pann/traincontrol/docs/AI for HW development.odp

## AI assisted Hardware development

March 2026 PA Nilsson

## Why use AI for electronics development?

## Exploratory phase

- Helps designer to better describe the project on a high level
  - Improved documentation for hand over or on-boarding of other engineers
- Based on high level requirements it can provide a good starting point on a block level

## Why use AI for electronics development?

## Implementation phase

- Component searches
  - Can provide component candidates based on soft high level requirements on components.
  - Verify component availability
- Power requirement calculations
  - Can produce good documentation on power budgets, reading datasheets and extracting data for all components in the design
- Find and download component symbols and create libraries where needed.
  - Can be instructed to analyze the design, then download and create missing components symbols and footprints.
- Draw a first block level schematics to set basic structure

## Why use AI for electronics development?

## Design review phase

- Act as an additional peer review participant
  - Review pinouts for component symbols and footprints
  - Find missing connections
- Power requirement calculations
  - Can produce good documentation on power budgets, reading datasheets and extracting data for all components in the design
- Find and download component symbols and create libraries where needed.
  - Can be instructed to analyze the design, then download and create missing components symbols and footprints.

## This work is licensed under a Creative Commons Attribution-ShareAlike 3.0 Unported License. It makes use of the works of Mateus Machado Luna.
