pann/traincontrol/docs/Rev1.0 review report.pdf

Traincontrol Shield -- Rev 1.0 Schematic Review | Date: 2026-03-02

# Traincontrol Shield

## Rev 1.0 Schematic Review Report

Review Date: 2026-03-02
Project: hw/traincontrol-shield/ Branch: hw-take2

## 1. Executive Summary

This report covers a schematic review of the traincontrol-shield KiCad project, a WiFi-enabled Marklin AC train controller shield for the ESP32-S3-DevKitC. The review focuses on the three project-local library components (MP2359DJ, DB107, BT134W-600D), their pinouts, reference circuit compliance, and LCSC/DigiKey availability. Standard KiCad library components were spot-checked for correct connections.
Result: 1 critical issue (missing Schottky diode), 3 warnings (component values), 1 sourcing concern (BT134W-600D out of stock on LCSC), and 1 informational note (DB107 pin numbering convention).

## 2. Scope of Review

Design input documents reviewed:
- docs/high-level-design.md - System architecture and hardware design
- hw/traincontrol-shield/PLAN.md - Implementation plan and design rules
- hw/traincontrol-shield/schematics-plan.md - Detailed schematic documentation
- hw/traincontrol-shield/BOM.md - Bill of materials
Schematic files reviewed (8 hierarchical sheets):
- traincontrol-shield.kicad_sch (top-level: connectors J4/J5/J6, sub-sheet instances)
- power-supply.kicad_sch (Sheet 1: DB107, MP2359DJ, bulk/output caps, feedback)
- zero-crossing.kicad_sch (Sheet 2: H11AA1 AC optocoupler)
- xor-interlock.kicad_sch (Sheet 3: 74LVC1G86 XOR + 74LVC2G08 dual AND)
- opto-triac-drive.kicad_sch (Sheet 4: 2x MOC3021 opto-TRIAC drivers)
- triacs-snubbers.kicad_sch (Sheet 5: 2x BT134W-600D + RC snubbers)
- rail-voltage-sense.kicad_sch (Sheet 6: resistor divider for ADC)
- mcu.kicad_sch (Sheet 7: ESP32-S3-DevKitC headers, LED, decoupling) Items checked:
- Pinouts of all project-local library components vs datasheets
- MP2359DJ reference circuit compliance
- Net naming consistency across sheets
- Hierarchical label connectivity
- LCSC part availability and JLCPCB assembly status
- DigiKey availability for all key components

## 3. Project-Local Component Review

The project-local library (libs/traincontrol-shield.kicad_sym) contains three components downloaded via easyeda2kicad. These are the only non-standard components and received detailed pinout verification against manufacturer datasheets.

### 3.1 MP2359DJ-LF-Z (U1) - Buck Converter

Ref | LCSC | Package | Footprint | Pinout | Status
U1 | C14259 | SOT-23-6 | Local lib | Verified OK | In stock

Pinout Verification (vs MPS datasheet):
Pin | Schematic | Datasheet | Match
1 | BST | BST | OK
2 | GND | GND | OK
3 | FB | FB | OK
4 | EN | EN | OK
5 | IN | IN | OK
6 | SW | SW | OK

Reference Circuit Compliance:

[CRITICAL] Missing Schottky freewheeling diode. The MP2359 is an asynchronous buck converter with no internal low-side MOSFET. An external Schottky diode (e.g. B230A, SS24, 2A/30V) must be connected from GND (anode) to SW node (cathode). Without this diode the converter will not function - inductor current has no path when the internal high-side switch turns off.
[WARNING] Bootstrap capacitor C9 = 100nF is 10x larger than datasheet recommendation of 10nF. While functional, it increases bootstrap charge time. Change C9 to 10nF.
[WARNING] Input decoupling capacitor C3 = 100nF is too small. Datasheet recommends 4.7uF ceramic (X5R/X7R) close to VIN pin. The 220uF electrolytic bulk cap (C1) has too much ESR/inductance at 1.4MHz switching frequency to serve as primary decoupling. Change C3 to 4.7uF ceramic. [WARNING] Feedback resistors R12=150k / R13=47k give VOUT = 0.81 x (1 + 150/47) = 3.39V (datasheet VFB = 0.810V typical, not 0.792V as noted in BOM). This is 2.7% high. Additionally, 150k top resistor is 3x larger than the recommended ~50k range and may affect loop stability. Datasheet recommends R1=49.9k, R2=16.2k for 3.3V output.
[OK] | EN tied to VIN for always-on operation: correct per datasheet.
[OK] | Inductor L1 = 4.7uH: within recommended 1-10uH range, matches typical application. Verify DC current
rating >= 1.5A.
[OK] Output capacitor C2 = 22uF: matches datasheet recommendation.

### 3.2 DB107 (D1) - Bridge Rectifier

Ref | LCSC | Package | Footprint | Pinout | Status
D1 | C2492 | DIP-4 THT | Local lib | See below | In stock

Pinout Verification:
Pin | Schematic | Std Datasheet | Match
1 | + (DC out) | ~ (AC in) | Differs
2 | - (DC out) | + (DC out) | Differs
3 | ~ (AC in) | ~ (AC in) | OK
4 | ~ (AC in) | - (DC out) | Differs
[INFO] | The easyeda2kicad symbol uses a non-standard pin numbering convention that differs from typical DB107 datasheets. However, since both the symbol AND footprint were downloaded together from LCSC/EasyEDA (C2492), the pad-to-pin mapping should be internally consistent. The physical board connections will be correct as long as the local footprint (DIO-BG-TH_DF) is used. Do NOT substitute a standard KiCad library footprint for this component without re-verifying pin mapping.
[OK] | Schematic connections are functionally correct: AC_IN and AC_RTN connect to the AC pins, +15VDC connects to the DC+ pin, GND connects to the DC- pin. The net assignments follow the design intent regardless of pin numbering convention.

### 3.3 BT134W-600D (Q1, Q2) - TRIACs

Ref | LCSC | Package | Footprint | Pinout | Status
Q1, Q2 | C253549 | SOT-223 | Local lib | Verified OK | OOS LCSC

Pinout Verification (vs NXP/WeEn datasheet):
Pin | Schematic | Datasheet | Match
1 | T1 (MT1) | T1 | OK
2 | T2 (MT2) | T2 | OK
3 | G (Gate) | G | OK
4 | T2 (tab) | T2 (heatsink) | OK
[OK] | Pinout matches NXP datasheet for SOT-223 package. All four pins verified correct.
[OK] | Circuit connections correct: MT1 to AC_RTN, MT2 to WINDING_A/B, Gate from opto-TRIAC via gate
resistor. RC snubbers (39 ohm / 10nF) across MT2-MT1.
[WARNING] LCSC C253549 is currently OUT OF STOCK (0 units). Part is available on DigiKey (~$0.55/ea, ships same day). For JLCPCB assembly, parts would need to be consigned or an alternative LCSC TRIAC sourced.

## 4. Part Availability Summary

### 4.1 LCSC / JLCPCB Assembly

LCSC | Component | Type | Stock | Price | Status
C14259 | MP2359DJ-LF-Z | Ext. | 490 | $2.63 | In stock
C2492 | DB107 | Ext. | 58,045 | $0.06 | In stock
C253549 | BT134W-600D | Ext. | 0 | $0.25 | OUT OF STOCK

All three project-local parts are JLCPCB 'Extended' components (not 'Basic'), incurring a one-time ~$3 setup fee per unique extended part per assembly order. Standard KiCad library components (passives, logic ICs, optocouplers) are not listed here as they use generic symbols and specific LCSC part numbers have not yet been assigned.

### 4.2 DigiKey Availability

Component | Package | Stock | Notes
MP2359DJ-LF-Z | SOT-23-6 | In stock | Ships same day
DB107 | DIP-4 THT | In stock | Multiple mfrs
BT134W-600D,115 | SOT-223 | In stock | ~$0.55/ea
H11AA1 | DIP-6 | In stock | Vishay/ON Semi
MOC3021 | DIP-6 | In stock | Lite-On/onsemi
74LVC1G86 | SOT-23-5 | In stock | Diodes/Nexperia/TI
74LVC2G08 | SC-70-6 | In stock | Nexperia/Diodes

All components are available on DigiKey with same-day shipping.

## 5. Schematic Connectivity Review

The hierarchical schematic structure was reviewed for correct inter-sheet connectivity. All signals verified to propagate correctly through the hierarchy.

### 5.1 Net Naming

The following net naming convention differences were noted between the design documentation and the actual schematics:

Design Doc Name | Schematic Name | Sheet | Status
GPIO_FWD | CTRL_A | XOR/MCU | Renamed
GPIO_REV | CTRL_B | XOR/MCU | Renamed
GATE_FWD | PHASE_A | XOR/Opto | Renamed
GATE_REV | PHASE_B | XOR/Opto | Renamed
TRIAC_FWD_G | TRIAC_A_GATE | Opto/TRIAC | Renamed
TRIAC_REV_G | TRIAC_B_GATE | Opto/TRIAC | Renamed
+15VDC | +15V | Power/Rail | Shortened
RAIL_SENSE | VSENSE | Rail/MCU | Shortened
LED_STATUS | LED_CTRL | MCU | Renamed
[INFO] | Net names in the schematics differ from the design documents (high-level-design.md and schematics-plan.md). The schematic names are more generic (CTRL_A/B, PHASE_A/B) while the doc names are more descriptive (GPIO_FWD/REV, GATE_FWD/REV). The documentation should be updated to match the schematics, or vice versa, to avoid confusion during layout and debugging.
[INFO] | The power net +15VDC (docs) vs +15V (schematic) mismatch could cause confusion. The schematic uses the KiCad standard power:+15V symbol. Consider updating the documentation to use +15V consistently.

### 5.2 Hierarchical Label Connectivity

All hierarchical sheet pins on the top-level sheet were verified to have matching hierarchical labels in their respective sub-sheets. Signal flow direction (input/output/bidirectional) is consistent across the hierarchy.
[OK] | All 12 inter-sheet signals correctly connected via global labels.
[OK] | Power nets (+15V, +3V3, GND) propagated via power symbols (no explicit wires needed).
[OK] | AC domain nets (AC_IN, AC_RTN) correctly isolated from logic domain by optocouplers.

### 5.3 MCU Pin Mapping

The ESP32-S3-DevKitC-1 is connected via two 22-pin headers (J1, J2). Signal assignments verified against the DevKitC-1 pinout:

Function | GPIO | Net | Header | SW Match
Motor FWD | 4 | CTRL_A | J1 pin 18 | Yes
Motor REV | 5 | CTRL_B | J1 pin 17 | Yes
Zero-cross | 6 | ZC_OUT | J1 pin 16 | Yes
Status LED | 8 | LED_CTRL | J1 pin 15 | Yes
Rail ADC | 2 | VSENSE | J2 pin 18 | Yes
[OK] | GPIO assignments match the software configuration in main/motor_control.c and main/status_led.c. GPIO 4/5/6/8/2 are correctly mapped to their intended functions.

## 6. Documentation Consistency

Cross-check of design input documents against the implemented schematics and BOM.

### 6.1 BOM vs Schematics

[OK] | All 36 components listed in BOM.md are present in the schematics.
[OK] | Component values match between BOM.md and schematic symbol properties.
[OK] | R10 = 27k (changed from 33k) correctly reflected in both BOM.md and schematic.
[OK] | Feedback resistors R12=150k, R13=47k present in both BOM and schematic.
[WARNING] | BOM.md states VFB = 0.792V for the MP2359DJ feedback calculation. The datasheet specifies
VFB = 0.810V (typical). This affects the calculated output voltage: 0.792V gives 3.31V, but 0.810V gives 3.39V. The BOM note should be corrected.
[WARNING] Missing Schottky diode not listed in BOM.md. Once added to the schematic, the BOM must be updated with the new component (e.g. B230A-13-F or SS24).

### 6.2 High-Level Design vs Schematics

[INFO] high-level-design.md specifies BTA204-600E (4A TO-220AB TRIAC). The schematic uses BT134W-600D (1A SOT-223). This substitution is documented in BOM.md but not in the high-level design document. Update high-level-design.md to reflect the actual part.
[INFO] high-level-design.md specifies snubber values 100 ohm / 100nF. The schematic uses 39 ohm / 10nF. Update the high-level design to match.
[INFO] high-level-design.md specifies ESP32-C3-MINI-1 as MCU. The schematic uses ESP32-S3-DevKitC-1 headers. This is a significant platform difference that should be documented. [INFO] Net naming differences between documentation and schematics (see Section 5.1). Recommend updating documentation to match actual schematic net names.

## 7. Findings Summary

### 7.1 Critical (must fix before fabrication)

1. Add external Schottky freewheeling diode (GND to SW node) for MP2359DJ

### 7.2 Warnings (should fix)

2. Change C9 (bootstrap) from 100nF to 10nF per datasheet
3. Change C3 (VIN decoupling) from 100nF to 4.7uF ceramic per datasheet
4. Change R12/R13 feedback resistors to 49.9k/16.2k per datasheet (or verify
current values are acceptable given VFB tolerance band)
5. Correct VFB value in BOM.md from 0.792V to 0.810V
6. BT134W-600D (C253549) out of stock on LCSC - plan for consignment or alternative

### 7.3 Informational (non-blocking)

### 7. DB107 pin numbering differs from standard datasheets (easyeda2kicad convention)

- Not a functional issue: symbol+footprint are internally consistent

### 8. Net names in schematics differ from design documents (see Section 5.1) 9. high-level-design.md has stale component specs (BTA204, ESP32-C3, snubber values) 10. All three LCSC parts are 'Extended' (setup fee per JLCPCB assembly order)

## 8. Recommended Actions

Before proceeding to PCB layout:

- 1. Add Schottky diode to power-supply sub-sheet and update generator script
- 2. Update C9, C3, R12, R13 values in schematic and BOM.md
- 3. Add new Schottky diode to BOM.md with LCSC part number
- 4. Re-run kicad-cli netlist export to validate updated schematics
- 5. Update high-level-design.md to reflect actual components and net names
- 6. Resolve BT134W-600D sourcing (consign from DigiKey or find LCSC alternative)
- 7. Assign LCSC part numbers to standard library components for JLCPCB assembly
