pann/traincontrol/hw/traincontrol-shield/mcu.kicad_sch

## KiCad design hw/traincontrol-shield/mcu.kicad_sch (2026-04-18)

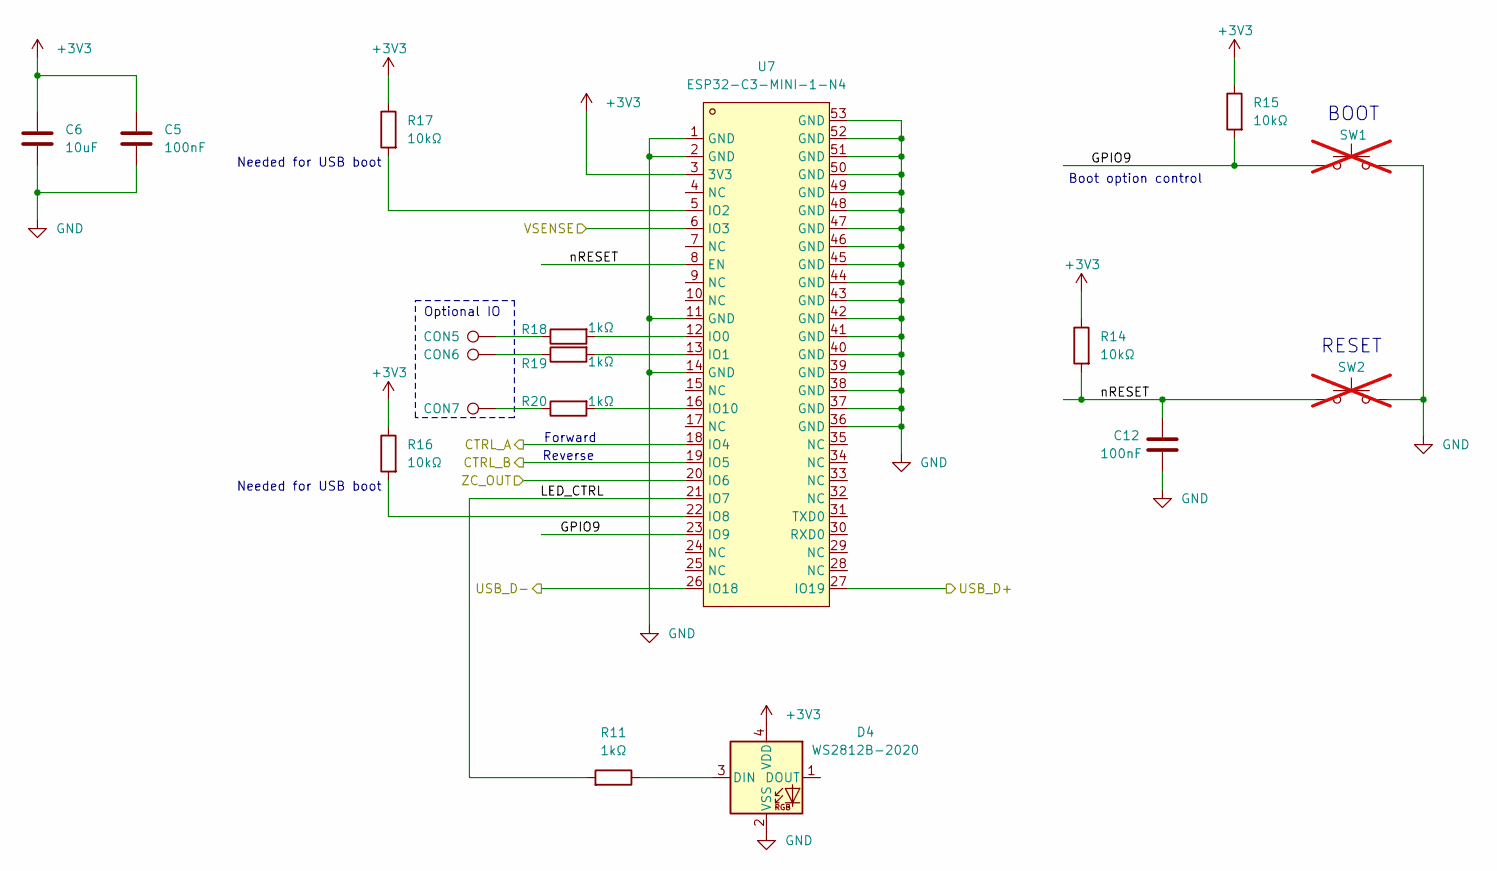
[picture p1: schematic mcu.kicad_sch]

Parts:
C5, C12: 100nF; C_0603_1608Metric
C6: 10uF; C_0603_1608Metric
CON5, CON6, CON7: ConnectionPad; TestPoint_Pad_D2.0mm
D4: WS2812B-2020; LED_WS2812B-2020_PLCC4_2.0x2.0mm
R11, R18, R19, R20: 1kΩ; R_0603_1608Metric
R14, R15, R16, R17: 10kΩ; R_0603_1608Metric
SW1, SW2: SW_Push; SW_SPST_TL3342; LCSC Part C318884; not fitted
U7: ESP32-C3-MINI-1-N4; WIFIM-SMD_ESP32-C3-MINI-1; LCSC Part C2838502

Connections:
+3V3: C5.2, C6.2, D4.4 (VDD), R14.1, R15.1, R16.1, R17.1, U7.3 (3V3)
CTRL_A: U7.18 (IO4)
CTRL_B: U7.19 (IO5)
GND: C5.1, C6.1, C12.2, D4.2 (VSS), SW1.2, SW2.2, U7.1 (GND), U7.2 (GND), U7.11 (GND), U7.14 (GND), U7.36 (GND), U7.37 (GND), U7.38 (GND), U7.39 (GND), U7.40 (GND), U7.41 (GND), U7.42 (GND), U7.43 (GND), U7.44 (GND), U7.45 (GND), U7.46 (GND), U7.47 (GND), U7.48 (GND), U7.49 (GND), U7.50 (GND), U7.51 (GND), U7.52 (GND), U7.53 (GND)
GPIO9: R15.2, SW1.1, U7.23 (IO9)
LED_CTRL: R11.2, U7.21 (IO7)
unnamed: CON5.1, R18.1
unnamed: CON6.1, R19.1
unnamed: CON7.1, R20.1
unnamed: D4.3 (DIN), R11.1
unnamed: R16.2, U7.22 (IO8)
unnamed: R17.2, U7.5 (IO2)
unnamed: R18.2, U7.12 (IO0)
unnamed: R19.2, U7.13 (IO1)
unnamed: R20.2, U7.16 (IO10)
USB_D+: U7.27 (IO19)
USB_D-: U7.26 (IO18)
VSENSE: U7.6 (IO3)
ZC_OUT: U7.20 (IO6)
nRESET: C12.1, R14.2, SW2.1, U7.8 (EN)

Notes on the sheet:
Optional IO
Reverse
Boot option control
Needed for USB boot
RESET
BOOT
Forward
