pann/traincontrol/hw/traincontrol-shield/opto-triac-drive.kicad_sch

## KiCad design hw/traincontrol-shield/opto-triac-drive.kicad_sch (2026-03-06)

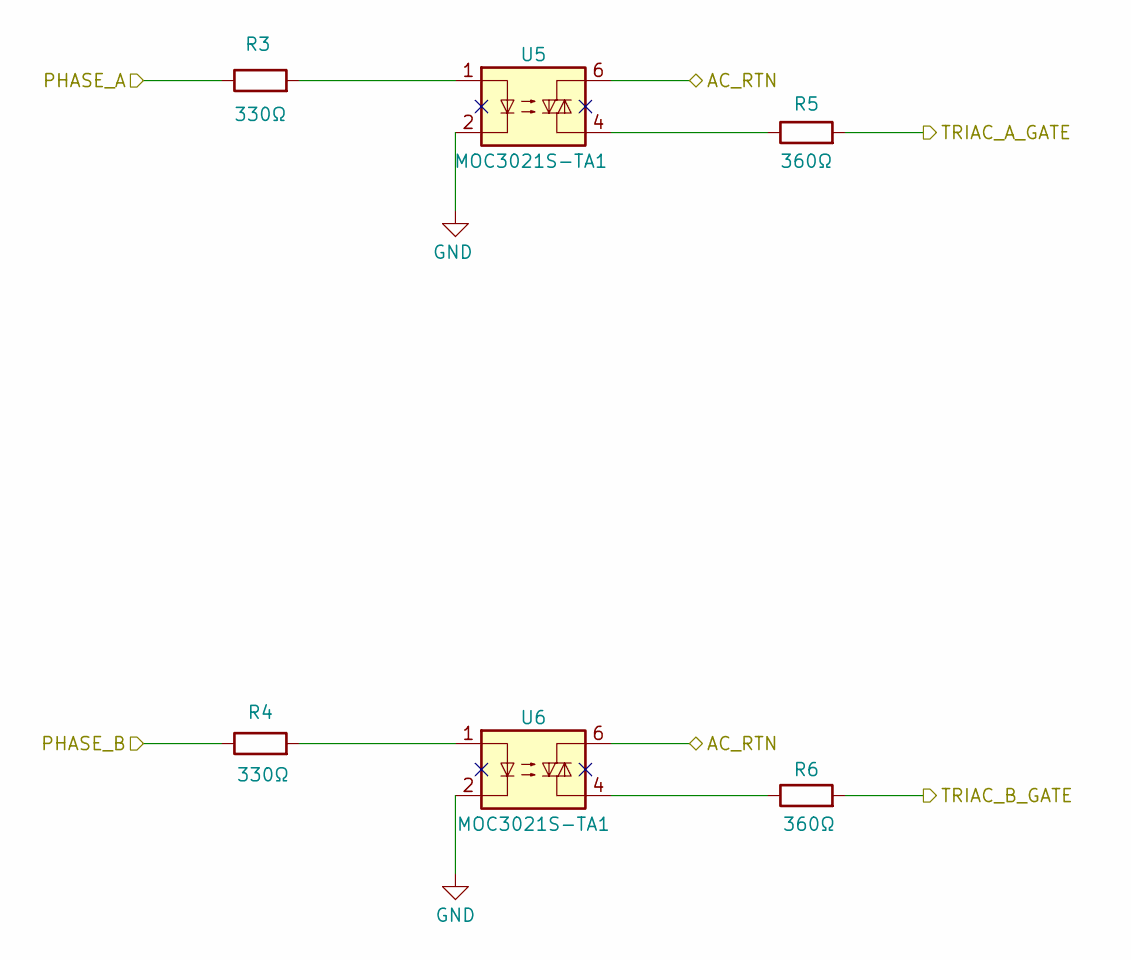
[picture p2: schematic opto-triac-drive.kicad_sch]

Parts:
R3, R4: 330Ω; R_0603_1608Metric
R5, R6: 360Ω; R_0603_1608Metric
U5, U6: MOC3021S-TA1; SMD-6_L7.3-W6.5-P2.54-LS10.2-BL; LCSC Part C115465

Connections:
AC_RTN: U5.6, U6.6
GND: U5.2, U6.2
unnamed: R3.2, U5.1
unnamed: R4.2, U6.1
unnamed: R5.1, U5.4
unnamed: R6.1, U6.4
PHASE_A: R3.1
PHASE_B: R4.1
TRIAC_A_GATE: R5.2
TRIAC_B_GATE: R6.2
