pann/traincontrol/hw/traincontrol-shield/power-supply.kicad_sch

## KiCad design hw/traincontrol-shield/power-supply.kicad_sch (2026-03-13)

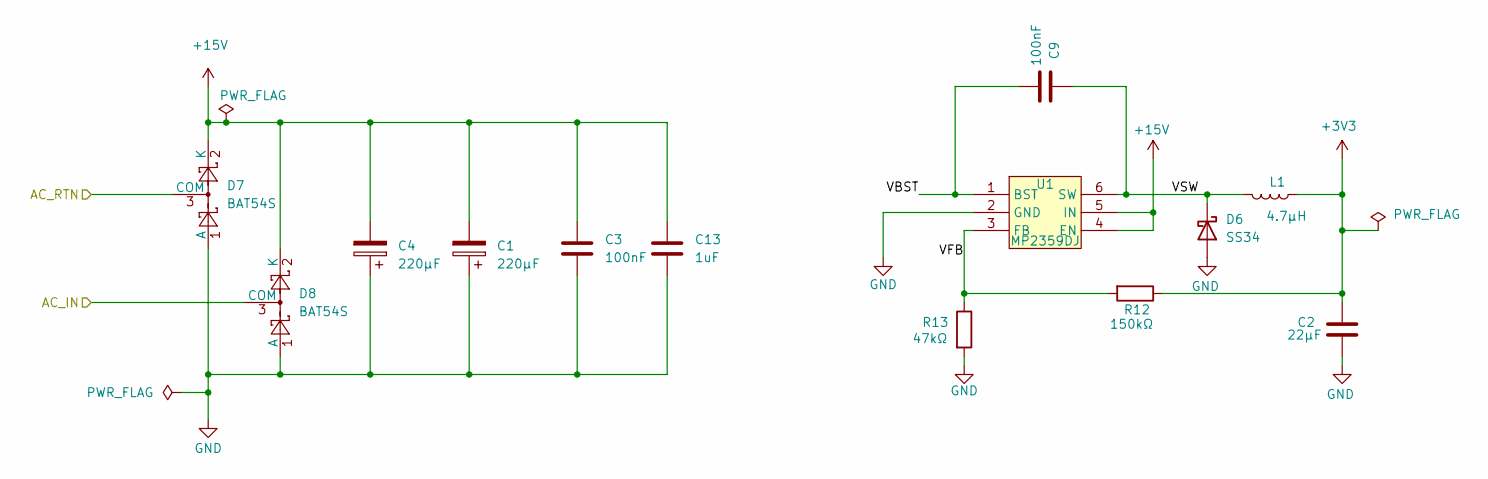
[picture p3: schematic power-supply.kicad_sch]

Parts:
C1, C4: 220µF; CP_Elec_6.3x7.7
C2: 22µF; C_0603_1608Metric
C3, C9: 100nF; C_0603_1608Metric
C13: 1uF; C_0603_1608Metric
D6: SS34; D_SMA
D7, D8: BAT54S; SOT-23
L1: 4.7µH; L_0805_2012Metric
R12: 150kΩ; R_0603_1608Metric
R13: 47kΩ; R_0603_1608Metric
U1: MP2359DJ; SOT-23-6_L2.9-W1.6-P0.95-LS2.8-BR

Connections:
+15V: C1.1, C1.2, C2.1, C2.2, C3.1, C3.2, C4.1, C4.2, C13.1, C13.2, D6.2 (A), D7.1 (A), D7.2 (K), D8.1 (A), D8.2 (K), L1.1, R12.1, R13.2, U1.2 (GND), U1.4 (EN), U1.5 (IN)
AC_IN: D8.3 (COM)
AC_RTN: D7.3 (COM)
VBST: C9.2, U1.1 (BST)
VFB: R12.2, R13.1, U1.3 (FB)
VSW: C9.1, D6.1 (K), L1.2, U1.6 (SW)
