pann/traincontrol/hw/traincontrol-shield/rail-voltage-sense.kicad_sch

## KiCad design hw/traincontrol-shield/rail-voltage-sense.kicad_sch (2026-03-06)

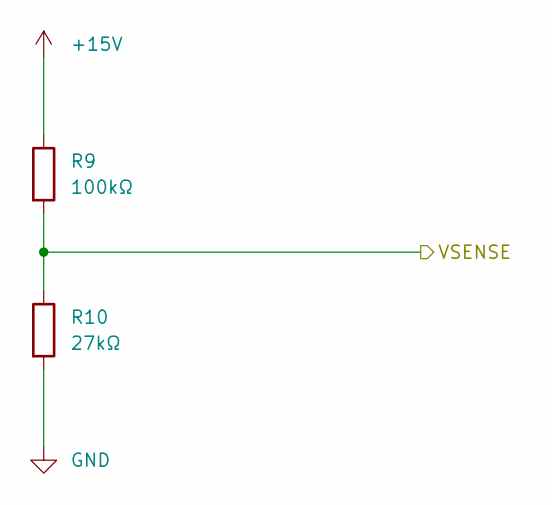
[picture p4: schematic rail-voltage-sense.kicad_sch]

Parts:
R9: 100kΩ; R_0603_1608Metric
R10: 27kΩ; R_0603_1608Metric

Connections:
+15V: R9.1
GND: R10.2
VSENSE: R9.2, R10.1
