pann/traincontrol/hw/traincontrol-shield/traincontrol-shield.kicad_sch

## KiCad design hw/traincontrol-shield/traincontrol-shield.kicad_sch (2026-04-18)

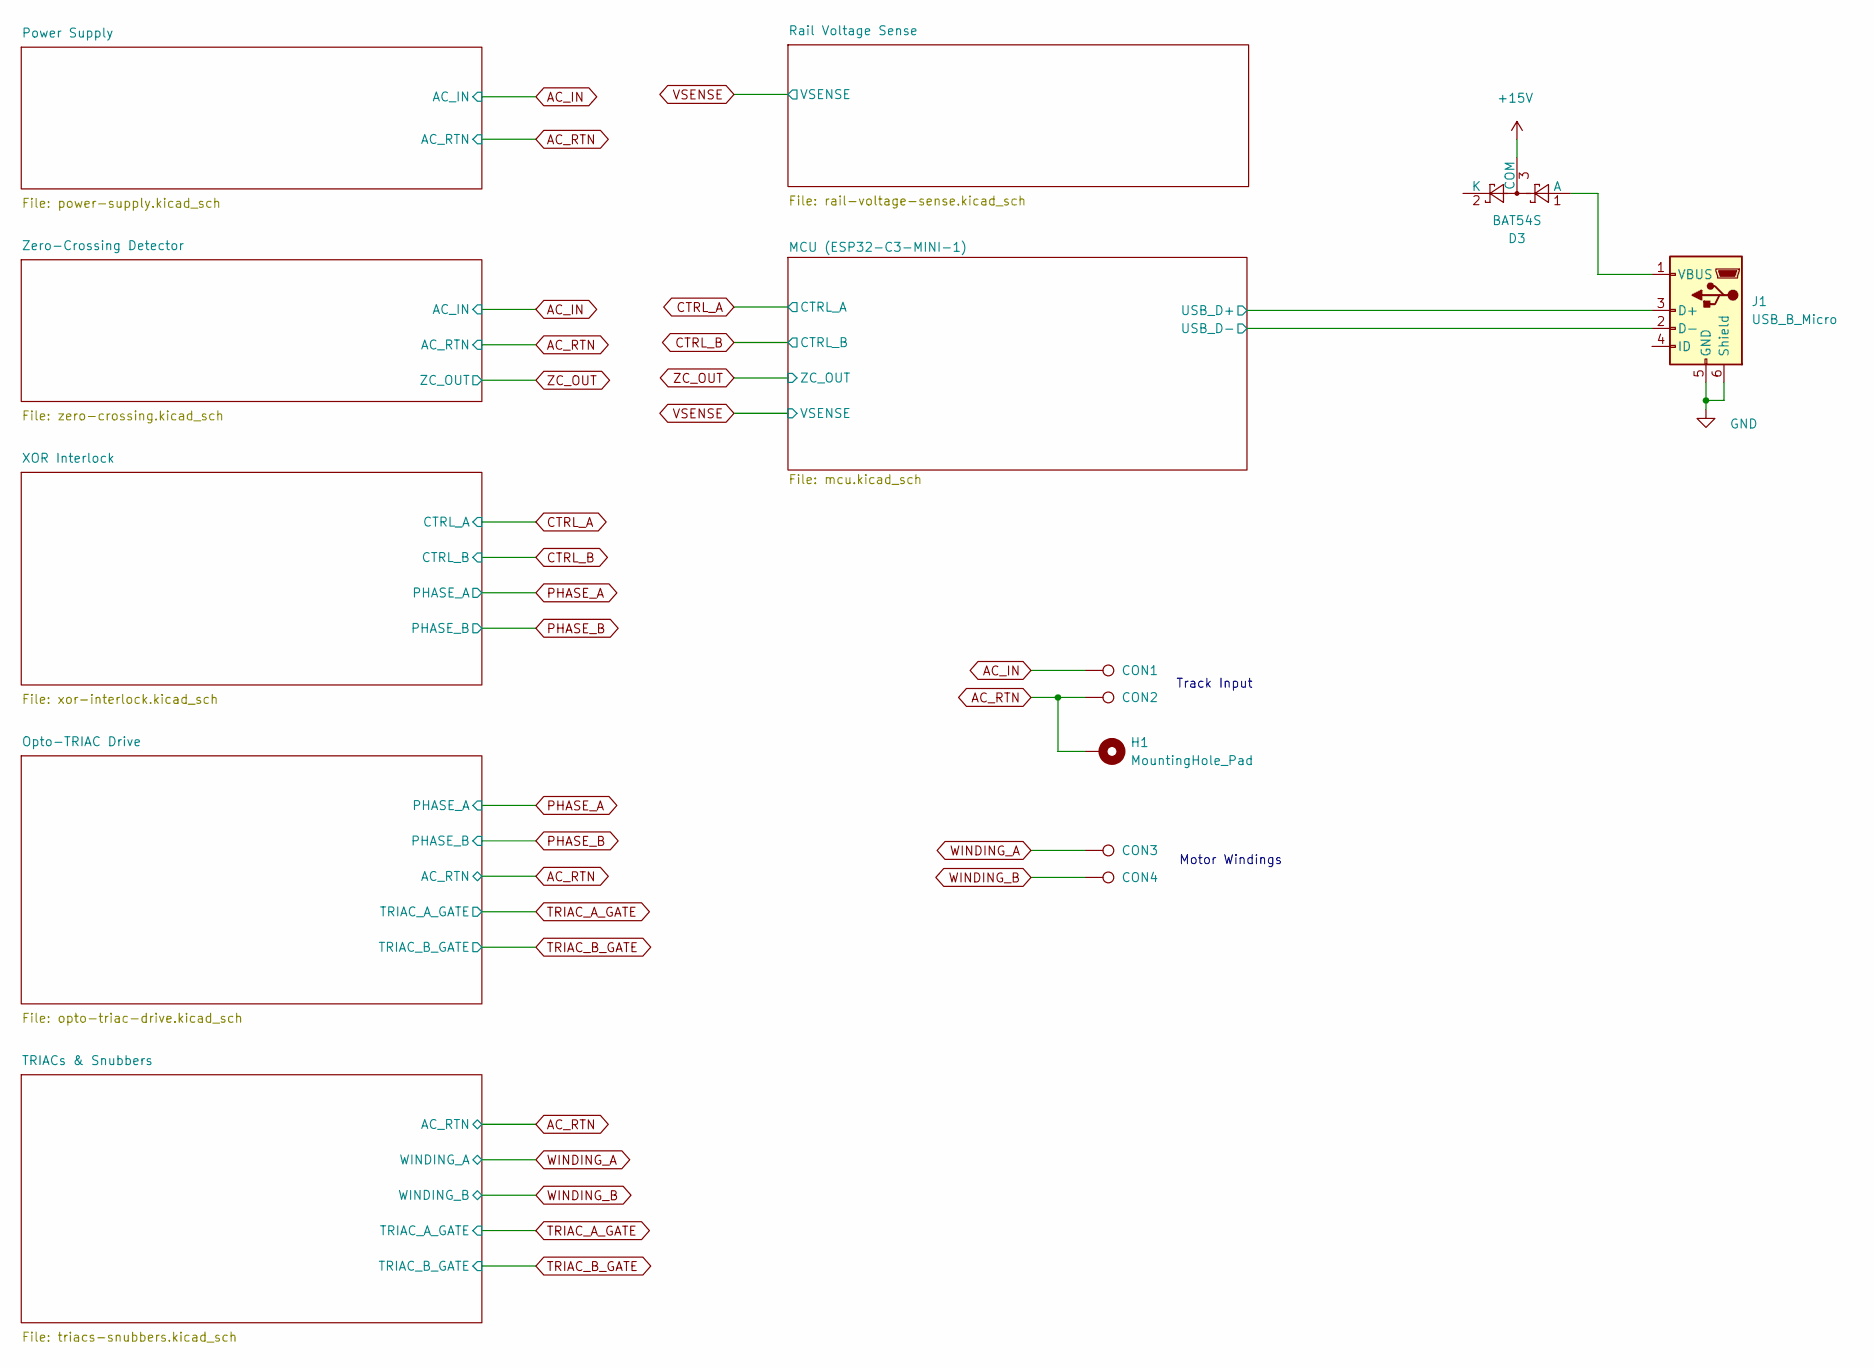
[picture p5: schematic traincontrol-shield.kicad_sch]

Parts:
CON1, CON2, CON3, CON4: ConnectionPad; TestPoint_Pad_D2.0mm
D3: BAT54S; SOT-23
H1: MountingHole_Pad; MountingHole_2.2mm_M2_Pad
J1: USB_B_Micro; USB_Micro-B_Molex-105017-0001

Connections:
+15V: D3.3 (COM)
AC_IN: CON1.1
AC_RTN: CON2.1, H1.1
GND: J1.5 (GND), J1.6 (Shield)
unnamed: D3.1 (A), J1.1 (VBUS)
USB_D+: J1.3 (D+)
USB_D-: J1.2 (D-)
WINDING_A: CON3.1
WINDING_B: CON4.1

Notes on the sheet:
Motor Windings
Track Input
