pann/traincontrol/hw/traincontrol-shield/triacs-snubbers.kicad_sch

## KiCad design hw/traincontrol-shield/triacs-snubbers.kicad_sch (2026-03-06)

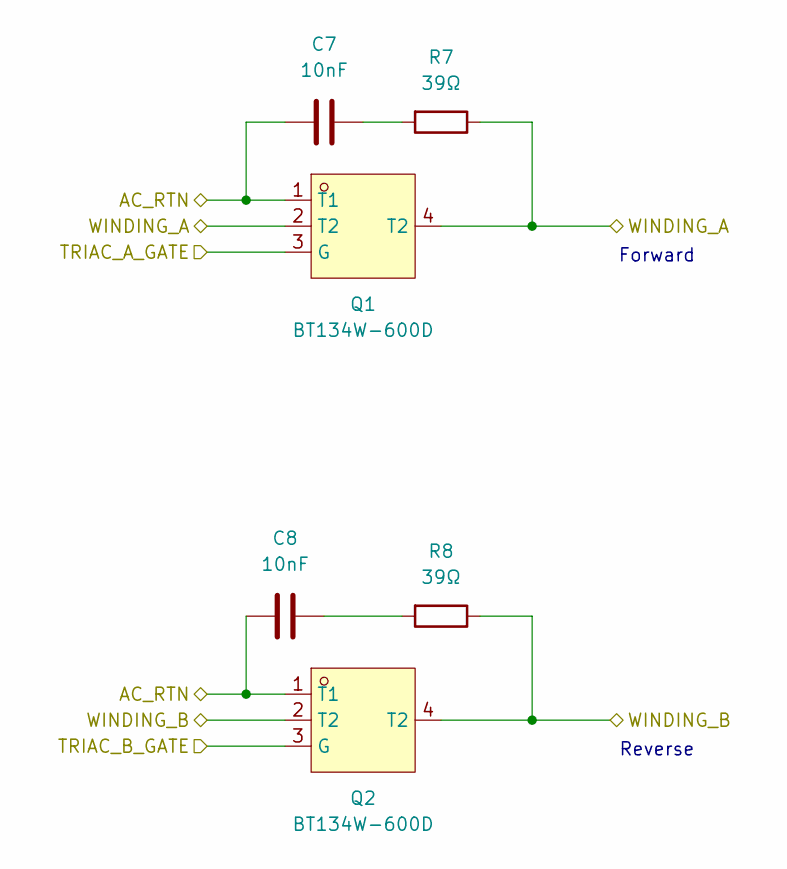
[picture p6: schematic triacs-snubbers.kicad_sch]

Parts:
C7, C8: 10nF; C_0603_1608Metric
Q1, Q2: BT134W-600D; SOT-223-3_L6.5-W3.4-P2.30-LS7.0-BR
R7, R8: 39Ω; R_0603_1608Metric

Connections:
AC_RTN: C7.2, C8.2, Q1.1 (T1), Q2.1 (T1)
unnamed: C7.1, R7.2
unnamed: C8.1, R8.2
TRIAC_A_GATE: Q1.3 (G)
TRIAC_B_GATE: Q2.3 (G)
WINDING_A: Q1.2 (T2), Q1.4 (T2), R7.1
WINDING_B: Q2.2 (T2), Q2.4 (T2), R8.1

Notes on the sheet:
Reverse
Forward
