pann/traincontrol/hw/traincontrol-shield/xor-interlock.kicad_sch

## KiCad design hw/traincontrol-shield/xor-interlock.kicad_sch (2026-03-06)

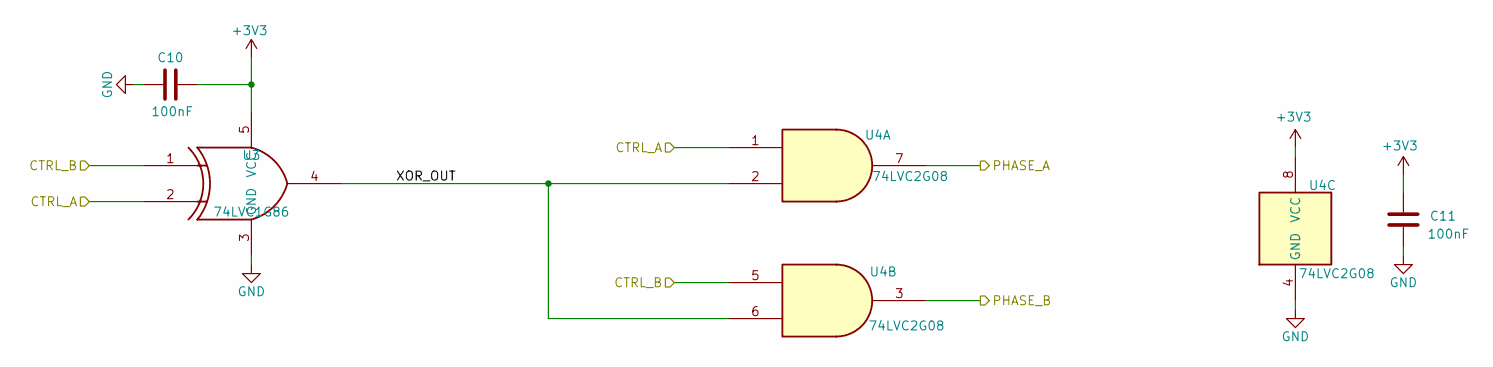
[picture p7: schematic xor-interlock.kicad_sch]

Parts:
C10, C11: 100nF; C_0603_1608Metric
U3: 74LVC1G86; SOT-23-5
U4: 74LVC2G08; VSSOP-8_2.3x2mm_P0.5mm

Connections:
+3V3: C10.2, C11.2, U3.5 (VCC), U4.8 (VCC)
CTRL_A: U3.2, U4.1
CTRL_B: U3.1, U4.5
GND: C10.1, C11.1, U3.3 (GND), U4.4 (GND)
PHASE_A: U4.7
PHASE_B: U4.3
XOR_OUT: U3.4, U4.2, U4.6
