pann/traincontrol/hw/traincontrol-shield/zero-crossing.kicad_sch

## KiCad design hw/traincontrol-shield/zero-crossing.kicad_sch (2026-03-13)

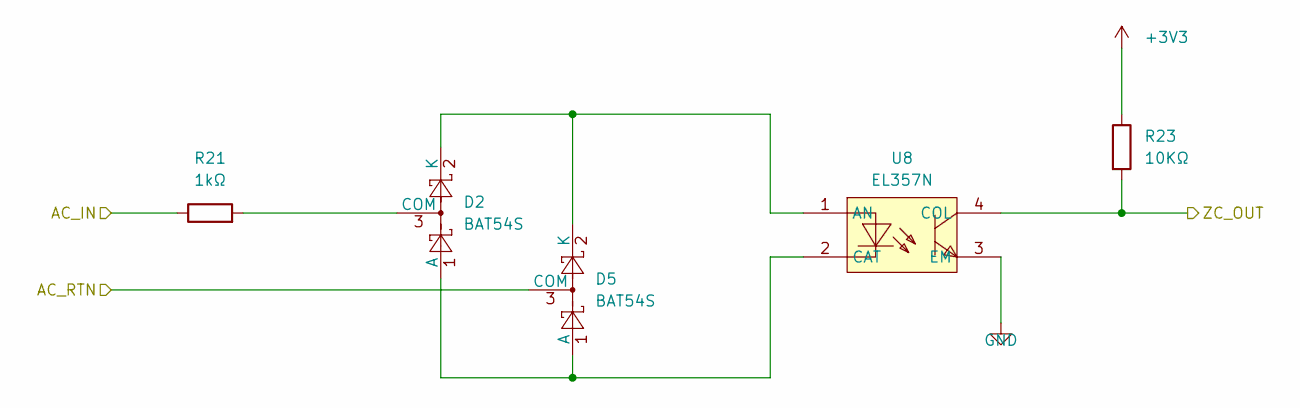
[picture p8: schematic zero-crossing.kicad_sch]

Parts:
D2, D5: BAT54S; SOT-23
R21: 1kΩ; R_0603_1608Metric
R23: 10KΩ; R_0603_1608Metric
U8: EL357N; OPTO-SMD-4_L4.4-W4.1-P2.54-LS7.0-TL

Connections:
+3V3: R23.1
AC_IN: R21.1
AC_RTN: D5.3 (COM)
GND: U8.3 (EM)
unnamed: D2.1 (A), D5.1 (A), U8.2 (CAT)
unnamed: D2.2 (K), D5.2 (K), U8.1 (AN)
unnamed: D2.3 (COM), R21.2
ZC_OUT: R23.2, U8.4 (COL)
