pann/traincontrol/sw/test/unit/fakes/driver/gpio.h

#pragma once

#include "esp_err.h"
#include <stdint.h>

typedef enum {
    GPIO_NUM_0 = 0,
    GPIO_NUM_1, GPIO_NUM_2, GPIO_NUM_3, GPIO_NUM_4,
    GPIO_NUM_5, GPIO_NUM_6, GPIO_NUM_7, GPIO_NUM_8,
    GPIO_NUM_9, GPIO_NUM_10,
} gpio_num_t;

typedef enum {
    GPIO_MODE_INPUT  = 0x01,
    GPIO_MODE_OUTPUT = 0x02,
} gpio_mode_t;

typedef enum {
    GPIO_PULLUP_DISABLE = 0,
    GPIO_PULLUP_ENABLE  = 1,
} gpio_pullup_t;

typedef enum {
    GPIO_PULLDOWN_DISABLE = 0,
    GPIO_PULLDOWN_ENABLE  = 1,
} gpio_pulldown_t;

typedef enum {
    GPIO_INTR_DISABLE  = 0,
    GPIO_INTR_NEGEDGE  = 2,
} gpio_int_type_t;

typedef struct {
    uint64_t       pin_bit_mask;
    gpio_mode_t    mode;
    gpio_pullup_t  pull_up_en;
    gpio_pulldown_t pull_down_en;
    gpio_int_type_t intr_type;
} gpio_config_t;

typedef void (*gpio_isr_t)(void *arg);

esp_err_t gpio_config(const gpio_config_t *cfg);
esp_err_t gpio_set_level(gpio_num_t pin, uint32_t level);
esp_err_t gpio_install_isr_service(int flags);
esp_err_t gpio_isr_handler_add(gpio_num_t pin, gpio_isr_t handler, void *arg);
