pann/traincontrol/sw/test/unit/fakes/esp_timer.h

#pragma once

#include "esp_err.h"
#include <stddef.h>
#include <stdint.h>

typedef struct esp_timer *esp_timer_handle_t;

typedef struct {
    void (*callback)(void *arg);
    void *arg;
    const char *name;
} esp_timer_create_args_t;

esp_err_t esp_timer_create(const esp_timer_create_args_t *args, esp_timer_handle_t *out);
esp_err_t esp_timer_start_once(esp_timer_handle_t timer, uint64_t timeout_us);
int64_t esp_timer_get_time(void);
