pann/traincontrol/sw/test/unit/fakes/nvs.h

#pragma once

#include "esp_err.h"
#include <stddef.h>

typedef enum {
    NVS_READONLY,
    NVS_READWRITE,
} nvs_open_mode_t;

typedef uint32_t nvs_handle_t;

esp_err_t nvs_open(const char *namespace_name, nvs_open_mode_t open_mode, nvs_handle_t *out_handle);
void      nvs_close(nvs_handle_t handle);
esp_err_t nvs_get_str(nvs_handle_t handle, const char *key, char *out_value, size_t *length);
esp_err_t nvs_set_str(nvs_handle_t handle, const char *key, const char *value);
esp_err_t nvs_commit(nvs_handle_t handle);
esp_err_t nvs_erase_all(nvs_handle_t handle);
