pann/traincontrol/(commit log)

2026-02-10 Add high-level design, ESP-IDF project skeleton, and VS Code setup
    Hardware design for TRIAC-based AC motor control with phase-angle speed
    control, zero-crossing detection, and hardware XOR interlock for the
    dual field windings. Software skeleton targets ESP32-C3 with Modbus TCP
    over WiFi. Includes VS Code workspace and ESP-IDF extension config.
2026-02-11 Add unit test and system test infrastructure
    Set up TDD testing framework with two levels:
    - Host-side unit tests (native gcc + Unity) for motor_control and config
    modules, with fake ESP-IDF headers and call-tracking state
    - On-target system test firmware (ESP32-S3-DevKitC) with serial REPL
    for manual oscilloscope verification and pytest-embedded automation
    - Wrapper scripts in sw/test/ for running tests
2026-02-12 Improve test infrastructure: auto-source IDF, LED feedback, docs
    - Shell scripts auto-source ESP-IDF export.sh with diagnostic output
    - System test firmware drives on-board RGB LED (green=fwd, red=rev,
    brightness=speed) for visual feedback without oscilloscope
    - Add led_strip component dependency
    - Add test_readme.md documenting test strategy and usage
    - Add VS Code tasks.json for building/flashing from the IDE
2026-02-12 Add event logging framework for serial monitoring
    Introduces event_log module with categorised event output (SYSTEM,
    MOTOR, WIFI, MODBUS, CONFIG) over serial via ESP_LOGI. Integrates
    into motor_control and config modules as reference, and adds
    placeholder calls plus reference comments to stub modules for
    future implementation. Includes unit test fakes with call tracking
    and system test wrapper component.
2026-02-15 Add KiCad PCB design skills (easyeda2kicad, kicad-pcb)
2026-02-18 Add WiFi manager, provisioning, Modbus TCP server, and status LED
    Implement the remaining traincontrol modules:
    - WiFi STA manager with mDNS, auto-reconnect, and event handling
    - Provisioning via SoftAP captive portal and USB serial CLI
    - Modbus TCP server (custom lightweight, FC01/03/04/05/06) with
    register map for motor control, 38 unit tests
    - Production CLI: speed, dir, enable, estop, status, mr, mw,
    modbus_status, wifi_set, wifi_status, factory_reset, reset
    - RGB status LED (WS2812) reflecting motor state: green=fwd,
    red=rev, brightness=speed
    - User guide documentation
    - System test integration with wrapper components
    [esp_console.h, esp_err.h, esp_event.h, esp_http_server.h, esp_netif.h, esp_timer.h, esp_wifi.h]
2026-02-20 Update BOM: change SMD passives to 0603, snubbers to 50V ceramic
    All resistors and SMD capacitors changed from 0805 to 0603.
    Snubber caps (C6, C7) changed from 250V film to 50V ceramic MLCC —
    adequate for 12VAC system where rectified peak is ~17V.
2026-02-20 Add BOM analysis with KiCad library mapping
    Document all components with KiCad symbol references, footprint
    assignments, and LCSC part numbers. Identifies MP2359DJ and USB4110-GF-A
    as needing download via easyeda2kicad.
2026-02-20 Add project library with downloaded MP2359DJ component
    Download MP2359DJ buck converter (LCSC C14259) via easyeda2kicad.
    Set up project-local symbol and footprint libraries under libs/.
    Update BOM with correct LCSC ID and remove unused USB-C connector.
2026-02-21 Add schematics implementation plan and align design documents
    - Add schematics-plan.md: full hierarchical schematic plan with per-sheet
    component tables, net naming, ground architecture, and phased implementation
    order (each phase gates on user review + git commit)
    - Update PLAN.md: add correct AC_RTN/GND ground architecture, library
    verification results, component sourcing status, and design notes
    - Update BOM.md: add missing components (R12/R13 buck FB resistors, C9
    bootstrap cap, C10/C11 logic IC decoupling), change R10 to 27kΩ (ADC
    safety), update DB107 and BTA204-600E to require easyeda2kicad download
2026-02-21 Phase 0 complete: download DB107 and BT134W-600D into project library
    - DB107 (LCSC C2492): symbol added to traincontrol-shield.kicad_sym,
    footprint DIO-BG-TH_DF.kicad_mod added to traincontrol-shield.pretty/
    - BT134W-600D (LCSC C253549): replaces BTA204-600E (TO-220AB, not on LCSC).
    SOT-223 SMD, 1A/600V, WeEn. Symbol + SOT-223-3 footprint added.
    - traincontrol-shield.kicad_sym now has 3 symbols: MP2359DJ-LF-Z, DB107, BT134W-600D
    - BOM.md, PLAN.md, schematics-plan.md updated to reflect part change
2026-02-21 Phase 1 complete: KiCad project files and symbol library corrections
    - traincontrol-shield.kicad_pro: new project file (version 3)
    - sym-lib-table: project-local symbol library registered
    - fp-lib-table: project-local footprint library registered
    - Symbol fixes in traincontrol-shield.kicad_sym:
    - MP2359DJ-LF-Z: reference "U" → "U?"
    - DB107: reference "UR" → "D?", footprint lib easyeda2kicad → traincontrol-shield
    - DB107 pin 3/4: "&#126;" → "~" (hidden), show pin number only
    - BT134W-600D: reference "Q" → "Q?", footprint lib easyeda2kicad → traincontrol-shield
    - BOM.md: C1 symbol Device:CP → Device:C_Polarized (CP does not exist in KiCad 8)
    - All standard KiCad symbols a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
2026-02-21 Phase 2 complete: create 8 empty schematic skeleton files
    traincontrol-shield.kicad_sch (top-level) + 7 sub-sheets:
    power-supply, zero-crossing, xor-interlock, opto-triac-drive,
    triacs-snubbers, rail-voltage-sense, mcu
    All files: KiCad 9 format, A4 paper, unique UUIDs, title blocks.
    No components placed yet.
    [mcu.kicad_sch, opto-triac-drive.kicad_sch, power-supply.kicad_sch, rail-voltage-sense.kicad_sch, traincontrol-shield.kicad_sch, triacs-snubbers.kicad_sch, xor-interlock.kicad_sch, zero-crossing.kicad_sch]
2026-02-22 Phase 3+4 complete: implement all 8 schematics, fix KiCad 9 lib embedding
    All 7 sub-sheets and top-level sheet fully implemented and validated with
    kicad-cli (exit 0 on all 8 files).
    Key fixes to lib_sym_entry() in generator scripts:
    - Sub-symbol names must NOT include library prefix (KiCad 9 parser requirement)
    - Local KiCad 6 library symbols upgraded inline: remove (id N) from properties,
    strip stroke colors, fix bare 'hide', add exclude_from_sim + embedded_fonts
    - Derived symbols (MOC3021M extends MOC3010M) flattened by copying base
    graphics into derived, removing (extends ...) for standalone embedding
    Validated: kicad-cli sch export netlist exits 0 for all 8 .kicad_sch files.
    Co-A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
    [mcu.kicad_sch, opto-triac-drive.kicad_sch, power-supply.kicad_sch, rail-voltage-sense.kicad_sch, traincontrol-shield.kicad_sch, triacs-snubbers.kicad_sch, xor-interlock.kicad_sch, zero-crossing.kicad_sch]
2026-02-22 Set exclude_from_sim=no for all power/GND symbols
    [mcu.kicad_sch, opto-triac-drive.kicad_sch, power-supply.kicad_sch, rail-voltage-sense.kicad_sch, traincontrol-shield.kicad_sch, triacs-snubbers.kicad_sch, xor-interlock.kicad_sch, zero-crossing.kicad_sch]
2026-02-22 Add 2.54mm wire stubs to all power and global label connections
    Power symbols (GND/+V) and global labels were placed directly on
    component pins, making connections invisible in KiCad GUI. Add a
    2.54mm stub wire between each component pin and power symbol/label
    so connections are visually distinct. GND stubs go down (+y), +V
    stubs go up (-y), label stubs go horizontally away from pin.
    PWR_FLAG symbols are excluded (already have explicit wires).
    All 8 schematics validate with kicad-cli exit 0.
    [mcu.kicad_sch, opto-triac-drive.kicad_sch, power-supply.kicad_sch, rail-voltage-sense.kicad_sch, traincontrol-shield.kicad_sch, triacs-snubbers.kicad_sch, xor-interlock.kicad_sch, zero-crossing.kicad_sch]
2026-02-22 Fix stub conflicts: prevent accidental cross-net connections
    Power symbol stubs were landing on adjacent component pins,
    creating unintended net connections (e.g. GND→VBST, GND→ZC_OUT,
    +3V3→CTRL_A, +3V3→VSENSE, GND→GPIO20/GPIO12).
    Fixes applied:
    - power-supply: U1 GND (pin2) routed left 2.54mm (BST pin1 was
    directly below); U1 IN (pin5) +15V routed right 2.54mm (EN
    pin4 +15V was directly above at same x).
    - zero-crossing: U2 GND (pin4) routed right 2.54mm (pin5/ZC_OUT
    was directly below at same x).
    - mcu: all J1/J2 connector power pins (GND, +3V3) routed left
    2.54mm before placing vertical stub, so power symbols sit
    outside the connector pin column and vertical stubs can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
    [mcu.kicad_sch, opto-triac-drive.kicad_sch, power-supply.kicad_sch, rail-voltage-sense.kicad_sch, traincontrol-shield.kicad_sch, triacs-snubbers.kicad_sch, xor-interlock.kicad_sch, zero-crossing.kicad_sch]
2026-02-22 Add Phase 5 to schematics-plan: schematic correctness checks
    Documents requirements for:
    - Structural validation via kicad-cli (exit 0 required)
    - Wire stub conflict checking: for every P() and glabel() call,
    verify stub endpoint doesn't land on an adjacent pin
    - Rules by symbol type (GND down, +V up, label left/right)
    - Special cases: tightly-packed ICs, 2.54mm-pitch connectors,
    PWR_FLAG exclusion
    - Table of all 7 conflicts found and fixed in this project
    - ERC cross-net error identification
2026-02-22 Fix annotation references to match BOM exactly
    Corrected opto-triac-drive sheet: moc_sheet(U6) used pwr_n=5 causing
    duplicate R5 (conflicting with U5's gate resistor) and wrong R7 for
    U6's gate (should be R6 per BOM). Changed to pwr_n=4 giving R4 (LED
    series) and R6 (gate). Regenerated all sheets for consistent UUIDs.
    Reference map now matches BOM:
    - power-supply: D1, U1, C1, C2, C3, C9, L1, R12, R13
    - zero-crossing: U2, R1, R2
    - xor-interlock: U3, U4, C10, C11
    - opto-triac-drive: U5, U6, R3, R4, R5, R6
    - triacs-snubbers: Q1, Q2, R7, R8, C7, C8
    - rail-voltage-sense: R9, R10
    - mcu: J1, J2, C4, C5, C6, D2, R11
    - top-level: J4, J5, J6
    All 8 schematics validate w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
    [mcu.kicad_sch, opto-triac-drive.kicad_sch, rail-voltage-sense.kicad_sch, traincontrol-shield.kicad_sch, triacs-snubbers.kicad_sch, xor-interlock.kicad_sch, zero-crossing.kicad_sch]
2026-02-22 Add hierarchical ports to all sub-sheets and top-level connections
    Replace inter-sheet global_label elements with hierarchical_label in all
    sub-sheets, so each sheet exports visible ports on its sheet box symbol
    in the top-level. Add matching (pin ...) entries to every sheet block in
    the top-level. Connect all sheet pins with bidirectional global_labels in
    the inter-column gap (x=105..120) so named nets auto-join.
    Port counts per sub-sheet:
    power-supply: 2 (AC_IN, AC_RTN)
    zero-crossing: 3 (AC_IN, AC_RTN, ZC_OUT)
    xor-interlock: 6 (CTRL_A×2, CTRL_B×2, PHASE_A, PHASE_B)
    opto-triac-drive: 6 (PHASE_A, PHASE_B, AC_RTN×2, TRIAC_A_GATE, TRIAC_B_GATE)
    triacs-snubbe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
    [mcu.kicad_sch, opto-triac-drive.kicad_sch, power-supply.kicad_sch, rail-voltage-sense.kicad_sch, traincontrol-shield.kicad_sch, triacs-snubbers.kicad_sch, xor-interlock.kicad_sch, zero-crossing.kicad_sch]
2026-02-23 Fix sheet pin justify direction so labels render inside sub-sheet boxes
    Pin text justification was inverted: angle=0 (right-border) pins need
    justify=right so text extends leftward (inside the sheet); angle=180
    (left-border) pins need justify=left so text extends rightward (inside).
    Validated against KiCad 9 subsheets demo format and kicad-cli netlist
    export (exit 0).
    [traincontrol-shield.kicad_sch]
2026-02-23 Disperse component layout and triple wire stub length across all sheets
    - STUB: 2.54 → 7.62 mm (3×) in all three generator scripts
    - Inter-component spacing doubled in power-supply, MCU, and logic sheets
    - Top-level inter-column gap widened (LX 120 → 130 mm) to avoid label collision
    - Sheet frame heights made variable per pin count (20–35 mm)
    - Right-column sheet x-origin and connector J4/J5/J6 x-positions updated accordingly
    - All 8 sheets regenerated and validated with kicad-cli
    [mcu.kicad_sch, opto-triac-drive.kicad_sch, power-supply.kicad_sch, rail-voltage-sense.kicad_sch, traincontrol-shield.kicad_sch, triacs-snubbers.kicad_sch, xor-interlock.kicad_sch, zero-crossing.kicad_sch]
2026-02-23 Fix U4 footprint: SOT-363_SC-70-6 (6-pin) → VSSOP-8_2.3x2mm_P0.5mm (8-pin)
    74LVC2G08 has 8 pins (dual AND gate + VCC/GND); SOT-363 only has 6 pads.
    Correct footprint is VSSOP-8 per the symbol's ki_fp_filters (SSOP*/VSSOP*).
    [xor-interlock.kicad_sch]
2026-02-23 Fix duplicate #PWR refs, top-level label placement, and sheet box width
    - #PWR references: assign unique page×100 offset per sheet (201..801 + 101
    for top-level) and standardise to #PWR{n:04d} format — eliminates duplicate
    reference designators across the project
    - Top-level glabel: place label (at x ...) in the inter-column gap rather than
    (at lx ...) at the sheet border; wire already spans border→gap correctly;
    no more floating wire endpoints or label body overlapping sheet-box pins
    - BOX_W: 90→65 mm, LX: 130→110 mm (gap 30 mm, label clearance 14.76 mm);
    connector J4/J5/J6 x: 260→190 mm to match new right-column right border
    - All 8 sheets regenerated and validated wit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
    [mcu.kicad_sch, opto-triac-drive.kicad_sch, power-supply.kicad_sch, rail-voltage-sense.kicad_sch, traincontrol-shield.kicad_sch, triacs-snubbers.kicad_sch, xor-interlock.kicad_sch, zero-crossing.kicad_sch]
2026-02-23 Fix U2 (H11AA1) schematic orientation for conventional NPN layout
    Mirror U2 vertically (mirror x) so emitter (pin 4) is at the
    bottom-right and base (pin 6) is at the top-right NC, matching
    the standard NPN symbol convention (emitter → GND at bottom,
    collector → pullup at centre). Also update R1, AC_IN and AC_RTN
    wire/label coordinates to match the new pin positions.
    [mcu.kicad_sch, opto-triac-drive.kicad_sch, rail-voltage-sense.kicad_sch, triacs-snubbers.kicad_sch, xor-interlock.kicad_sch, zero-crossing.kicad_sch]
2026-02-23 Revert "Fix U2 (H11AA1) schematic orientation for conventional NPN layout"
    This reverts commit 6bef0f34c2064906dba6c87f8e1f2308b0ec682e.
    [mcu.kicad_sch, opto-triac-drive.kicad_sch, rail-voltage-sense.kicad_sch, triacs-snubbers.kicad_sch, xor-interlock.kicad_sch, zero-crossing.kicad_sch]
2026-02-23 Fix U2 (H11AA1) zero-crossing wiring: emitter→GND, base→NC
    KiCad symbol coords use y-up convention, so schematic positions
    are cy ∓ symbol_y. Pin 4 (Emitter) is at cy+2.54 (lower-right)
    and Pin 6 (Base) is at cy-2.54 (upper-right) — the previous code
    had these swapped, connecting GND to the base and NC to the emitter.
    [mcu.kicad_sch, opto-triac-drive.kicad_sch, rail-voltage-sense.kicad_sch, triacs-snubbers.kicad_sch, xor-interlock.kicad_sch, zero-crossing.kicad_sch]
2026-02-23 Fix hierarchical label orientations: angle=0 → angle=180 throughout
    All hlabel calls in zero-crossing, xor-interlock, opto-triac-drive, and
    rail-voltage-sense sub-sheets were using angle=0, causing the label arrows
    to point in the wrong direction. Changed to angle=180 uniformly; for
    left-side labels also shifted x by −STUB so the label connection pin
    coincides with the circuit element, keeping the label body outside the
    schematic area.
    [mcu.kicad_sch, opto-triac-drive.kicad_sch, power-supply.kicad_sch, rail-voltage-sense.kicad_sch, traincontrol-shield.kicad_sch, triacs-snubbers.kicad_sch, xor-interlock.kicad_sch, zero-crossing.kicad_sch]
2026-02-23 Revert "Fix hierarchical label orientations: angle=0 → angle=180 throughout"
    This reverts commit 593a08d7401abe541600d63447176c71f07219f1.
    [mcu.kicad_sch, opto-triac-drive.kicad_sch, power-supply.kicad_sch, rail-voltage-sense.kicad_sch, traincontrol-shield.kicad_sch, triacs-snubbers.kicad_sch, xor-interlock.kicad_sch, zero-crossing.kicad_sch]
2026-02-24 Fix hierarchical label placement and orientation in sub-sheets
    Root cause: hlabel() placed the label at lx (stub tip) instead of x
    (circuit connection point), mirroring the Issue-2 glabel bug fixed in
    commit 2270223.
    Fix applied to hlabel():
    (at {lx} ...) → (at {x} ...) — label now sits at the circuit endpoint
    Angle convention (matches label body direction):
    angle=180 → body extends LEFT — left-side input/bidirectional labels
    angle=0 → body extends RIGHT — right-side output/bidirectional labels
    Sheets affected: zero-crossing, xor-interlock, opto-triac-drive,
    rail-voltage-sense; triacs-snubbers and mcu already had correct angles.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
    [mcu.kicad_sch, opto-triac-drive.kicad_sch, power-supply.kicad_sch, rail-voltage-sense.kicad_sch, traincontrol-shield.kicad_sch, triacs-snubbers.kicad_sch, xor-interlock.kicad_sch, zero-crossing.kicad_sch]
2026-02-24 Fix hlabel placement in power-supply sheet
    Same lx→x fix applied to gen_power_supply.py's hlabel() function.
    AC_IN and AC_RTN labels (angle=180, left-side inputs) now placed at
    the circuit connection point instead of the stub tip.
    [power-supply.kicad_sch]
2026-02-24 Fix stub wire short-circuit across R3/R5 in opto-triac sheet
    With the label placed at x (circuit pin), the STUB wire from x to lx
    was spanning the entire resistor body — creating a direct short across
    both the LED series resistor (R3/R4) and the gate resistor (R5/R6).
    Fix: shift x outward by one STUB so the stub wire terminates at the
    resistor's outer pin rather than running across it:
    phase label: x = cx-7.62-3.81-3.81-STUB (lx lands on R pin2)
    gate label: x = gx+3.81+STUB (lx lands on R gate pin1)
    [opto-triac-drive.kicad_sch]
2026-02-24 Fix hlabel stub short-circuits on zero-crossing and power-supply pages
    The hlabel() stub wire ran from the circuit pin inward, crossing directly
    over series components and creating short-circuits:
    - zero-crossing AC_IN: stub spanned R1 (x 81.28→88.90); shift x to 73.66
    - power-supply AC_IN: stub crossed D1 body (x 40.64→48.26); shift x to 33.02
    - power-supply AC_RTN: same; shift x to 33.02
    Pattern: for angle=180 labels, x = component_inner_pin - STUB so the
    stub terminates at the component outer pin rather than spanning across it.
    All 8 sheets validate with kicad-cli.
    [mcu.kicad_sch, opto-triac-drive.kicad_sch, power-supply.kicad_sch, rail-voltage-sense.kicad_sch, traincontrol-shield.kicad_sch, triacs-snubbers.kicad_sch, xor-interlock.kicad_sch, zero-crossing.kicad_sch]
2026-02-24 Fix hlabel stub direction: stubs now extend away from IC, not into it
    Root cause: hlabel() used dx = +STUB for angle=180 and -STUB for angle=0,
    which caused every stub wire to run INTO the IC body instead of outward.
    This made wires appear to connect at the inner (wrong) end of all pins.
    Fix: negate dx so stubs always extend outward from the pin tip:
    angle=180 (left-side input): dx = -STUB → stub extends LEFT ✓
    angle=0 (right-side output): dx = +STUB → stub extends RIGHT ✓
    Also revert the x-position workarounds that compensated for the wrong
    stub direction (zero-crossing AC_IN, opto-triac PHASE/GATE, power-supply
    AC_IN/RTN): these are now back at the actual component pin po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
    [mcu.kicad_sch, opto-triac-drive.kicad_sch, power-supply.kicad_sch, rail-voltage-sense.kicad_sch, traincontrol-shield.kicad_sch, triacs-snubbers.kicad_sch, xor-interlock.kicad_sch, zero-crossing.kicad_sch]
2026-02-24 Remove accidentally committed KiCad autosave file
2026-02-24 gitignore: exclude KiCad autosave files
2026-02-24 Fix net_label angle for left-side input pins in XOR-interlock sheet
    XOR_OUT labels at U4A pin1 and U4B pin5 (left-side inputs) were using
    angle=0, causing the label text to run rightward into the IC body.
    Changed to angle=180 so text extends leftward, matching the convention
    established for all left-side signals.
    U3's output label (right-side, angle=0) is unchanged.
    [mcu.kicad_sch, opto-triac-drive.kicad_sch, rail-voltage-sense.kicad_sch, triacs-snubbers.kicad_sch, xor-interlock.kicad_sch, zero-crossing.kicad_sch]
2026-02-24 Revert "Fix net_label angle for left-side input pins in XOR-interlock sheet"
    This reverts commit d6ebceebdd755df04f496dcd3057f6a3fbaeb5a3.
    [mcu.kicad_sch, opto-triac-drive.kicad_sch, rail-voltage-sense.kicad_sch, triacs-snubbers.kicad_sch, xor-interlock.kicad_sch, zero-crossing.kicad_sch]
2026-02-24 Track KiCad schematic generator scripts in version control
    Move hw/traincontrol-shield/tmp/ out of .gitignore and add all four
    generator scripts:
    - gen_all_sheets.py — sub-sheets 2–7 (zero-crossing through MCU)
    - gen_power_supply.py — power supply sheet
    - gen_top_level.py — top-level hierarchy sheet
    - upgrade_local_lib.py — KiCad 6→9 local library upgrader
2026-02-24 Fix hlabel placement: label sits at stub outer end (lx), not pin tip (x)
    The hierarchical label connection point must be at lx (the outer end of
    the stub wire), not at x (the IC pin tip). With the label at x, it was
    overlapping the pin itself instead of sitting at the end of the routing
    stub where it belongs.
    angle=180 (left-side): lx = x - STUB → label to the left of pin ✓
    angle=0 (right-side): lx = x + STUB → label to the right of pin ✓
    Wire still runs x↔lx, connecting the IC pin to the label connection.
    Updated gen_all_sheets.py and gen_power_supply.py.
    [mcu.kicad_sch, opto-triac-drive.kicad_sch, power-supply.kicad_sch, rail-voltage-sense.kicad_sch, traincontrol-shield.kicad_sch, triacs-snubbers.kicad_sch, xor-interlock.kicad_sch, zero-crossing.kicad_sch]
2026-02-24 Add wire stub to net_label, matching hlabel placement convention
    net_label() now generates a short wire stub (length STUB) between the
    component pin tip (x) and the label connection point (lx), placing the
    label at the outer end of the stub — identical to how hlabel works:
    angle=180 (left-side): lx = x - STUB, label left of pin ✓
    angle=0 (right-side): lx = x + STUB, label right of pin ✓
    Also fix XOR_OUT net labels at U4A/B left-side input pins (angle=0→180)
    so their stubs extend leftward away from the IC body.
    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
    [mcu.kicad_sch, opto-triac-drive.kicad_sch, power-supply.kicad_sch, rail-voltage-sense.kicad_sch, traincontrol-shield.kicad_sch, triacs-snubbers.kicad_sch, xor-interlock.kicad_sch, zero-crossing.kicad_sch]
2026-02-24 Increase component spacing to eliminate pin-wire overlaps
    - zero-crossing: move R1 left 7.62mm, add bridge wire to U2 pin2
    - xor-interlock: move C10 right of U3 output (76→91mm), move C11 right (168→178mm)
    - opto-triac: add 7.62mm COMP_GAP between MOC3021 and LED/gate resistors
    - triacs-snubbers: move snubber column right (99→109mm), add 7.62mm gap between R and C
    - mcu: widen C4/C5/C6 decap spacing from 7.62mm to 10.16mm
    - power-supply: move R13 down 7.62mm, add bridge wire to R12
    [mcu.kicad_sch, opto-triac-drive.kicad_sch, power-supply.kicad_sch, rail-voltage-sense.kicad_sch, traincontrol-shield.kicad_sch, triacs-snubbers.kicad_sch, xor-interlock.kicad_sch, zero-crossing.kicad_sch]
2026-02-24 Fix power-symbol stub direction for vertical IC power pins
    power_sym() assumed VCC pins are always at the top (stub UP) and GND at
    the bottom (stub DOWN). SOT-23/VSSOP power units (74LVC1G86, 74LVC2G08)
    have the opposite layout: VCC exits at the bottom, GND at the top.
    Add angle=180 mode to power_sym() that flips the stub direction:
    angle=0 (default): VCC stub UP, GND stub DOWN
    angle=180 (flipped): VCC stub DOWN, GND stub UP
    Apply angle=180 to U3 (74LVC1G86) and U4 (74LVC2G08) VCC/GND calls
    in gen_xor_interlock so stubs exit away from the IC body.
    Same docstring/logic fix applied to gen_power_supply.py's copy.
    [xor-interlock.kicad_sch]
2026-02-24 Fix VCC/GND pin coordinates for U3/U4 power units; revert stub direction
    The U3 (74LVC1G86) and U4 (74LVC2G08) pin y-coordinates were swapped:
    VCC was listed at the bottom and GND at the top, opposite of the actual
    KiCad symbol layout. This caused stubs to run into the IC body and
    placed the wrong power net on each pin.
    Corrected assignments (center y ∓ 10.16mm):
    U3: VCC pin5 at y=80.01 [top], GND pin3 at y=100.33 [bottom]
    U4: VCC pin8 at y=99.06 [top], GND pin4 at y=119.38 [bottom]
    Reverts power_sym() to the original simple stub logic — VCC stub UP
    (y-STUB), GND stub DOWN (y+STUB) — which is correct once the pin
    positions are right.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
    [xor-interlock.kicad_sch]
2026-02-24 Enforce IC-to-passive body gap ≥ 2×STUB across all sheets
    Computed symbol body extents from KiCad library and applied:
    IC-to-IC gap = 4×STUB = 30.48mm between body edges
    IC-to-passive = 2×STUB = 15.24mm between body edges
    Violations found and fixed:
    - zero-crossing: R1 center 77.47→73.66mm (R1 body right→U2 body left = 15.24mm ✓)
    - zero-crossing: R2 center 116.84→119.38mm (U2 body right→R2 body left = 16.76mm ✓)
    - opto-triac: COMP_GAP 7.62→15.24mm (MOC body edge to R body edge = 19.05mm ✓)
    All other spacings were already compliant (xor-interlock U3→U4 50.8mm,
    triacs-snubbers TRIAC→R-sn 18mm, power-supply D1→C1 38mm).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
    [opto-triac-drive.kicad_sch, traincontrol-shield.kicad_sch, zero-crossing.kicad_sch]
2026-02-24 Apply omnidirectional spacing rule: move R12/R13 divider above U1
    R13 body bottom was only 2.54mm above U1 body top — violates the
    IC-to-passive body-edge gap minimum of 2×STUB = 15.24mm.
    Move R12/R13 up so R13 body bottom sits exactly 15.24mm above U1:
    R13 centre y: 58.42 → 45.72 (body bottom 48.26 → gap 15.24mm ✓)
    R12 centre y: 43.18 → 30.48 (maintains 15.24mm centre spacing to R13)
    All other sheets audited — no other vertical violations found.
    All 8 schematics regenerated and validated (kicad-cli PASS).
    [mcu.kicad_sch, opto-triac-drive.kicad_sch, power-supply.kicad_sch, rail-voltage-sense.kicad_sch, traincontrol-shield.kicad_sch, triacs-snubbers.kicad_sch, xor-interlock.kicad_sch, zero-crossing.kicad_sch]
2026-02-24 Fix U1 left-side net_label direction; move C9 clear of pin column
    Issue 1 — C9 was placed only 1×STUB left of U1's BST/GND/FB pin column
    (x=149.86), causing its net_label stubs to land exactly at U1's pin tips
    (x=157.48), visually grouping C9 with U1. Move C9 left by 2×STUB:
    x: 149.86 → 134.62 (stubs now end at 142.24, 15.24mm clear of pins) ✓
    Issue 2 — VBST and VFB net_labels on U1's left-side pins (BST pin1,
    FB pin3) used angle=0, so their stubs pointed RIGHT into the IC body.
    Changed to angle=180 so stubs point LEFT (away from IC), matching the
    left-exit direction of those pins.
    [power-supply.kicad_sch]
2026-03-03 Fix schematic ERC errors: pin Y-flip, PWR_FLAG, label wiring, spacing
    - Fix connector pin positions using Y-flip convention (sym Y-up → sch Y-down)
    - Add GND PWR_FLAG to power-supply sheet (eliminates power_pin_not_driven)
    - Fix top-level connector label placement: labels at stub end, wires toward pins
    - Apply omnidirectional spacing and IC-to-passive body gap rules across sheets
    - Update schematics-plan.md with ERC workflow and coordinate conventions
    - Regenerate all sub-sheets with corrected generator scripts
    ERC result: 138 violations (all warnings/cosmetic), 0 critical errors.
    [mcu.kicad_sch, opto-triac-drive.kicad_sch, power-supply.kicad_sch, rail-voltage-sense.kicad_sch, traincontrol-shield.kicad_sch, triacs-snubbers.kicad_sch, xor-interlock.kicad_sch, zero-crossing.kicad_sch]
2026-03-06 Schematic updates by hand.
    [mcu.kicad_sch, opto-triac-drive.kicad_sch, power-supply.kicad_sch, rail-voltage-sense.kicad_sch, traincontrol-shield.kicad_sch, triacs-snubbers.kicad_sch, xor-interlock.kicad_sch, zero-crossing.kicad_sch]
2026-03-13 Update BOM, docs, and JLCPCB outputs to match current schematics
    - Update BOM.md with JLCPCB LCSC part numbers for all components
    - Generate JLCPCB BOM and CPL files for PCBA ordering
    - Update docs and README to reflect component changes (BAT54S/SS34
    rectification, BT134W-600E TRIACs, EL357N optocoupler, ESP32-C3)
    - Suppress ERC warnings for unspecified pin connections in project settings
    [jlcpcb-bom.csv, mcu.kicad_sch, power-supply.kicad_sch, traincontrol-shield.kicad_sch, zero-crossing.kicad_sch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]
2026-04-18 Port firmware to ESP32-C3-MINI-1 and replace mDNS with UDP discovery
    Hardware migration (new shield revision, integrated ESP32-C3-MINI-1-N4):
    - sdkconfig target esp32s3 -> esp32c3
    - LED_GPIO 48 -> 7 (WS2812B-2020 on LED_CTRL / IO7)
    - Implement rail-voltage sense via ADC1_CH3 (IO3), dividing R9/R10
    - Schematic sheet titles "MCU (ESP32-S3-DevKitC)" -> "MCU (ESP32-C3-MINI-1)"
    Replace mDNS with custom UDP discovery beacon (port 55502, 5s interval):
    - mdns_hostname_set() hangs indefinitely on this board unless USB is
    attached; the managed espressif/mdns component's service_add paths
    require the main hostname, which only hostname_set() can set, so
    delegated-hostname workarounds hit the same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
    [mcu.kicad_sch, traincontrol-shield.kicad_sch]
2026-04-18 Fix scheduler wedge on AC-only by removing USB-Serial-JTAG REPL
    Root cause of the long-running "only works with USB attached" issue:
    esp_console_new_repl_usb_serial_jtag() installs the USB-Serial-JTAG VFS
    driver and sets stdout to blocking mode. With the C3's native USB and no
    host attached, the CDC TX FIFO fills up and subsequent writes hold
    newlib's stdio lock indefinitely, starving every task that logs. Plugging
    USB drained the FIFO and everything resumed — explaining every earlier
    "works with USB, dead without" symptom (mDNS probe hang, Modbus silent,
    broadcast beacon not firing).
    Changes:
    - provisioning.c: remove esp_console_*_repl setup. Provisioning is
    already handled via the Sof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
    [discovery.c, discovery.h, provisioning.c, status_led.c, wifi_manager.c]
